Ahmedredamohamed2022/EF_R2RVC02/doc/_static/layout.png

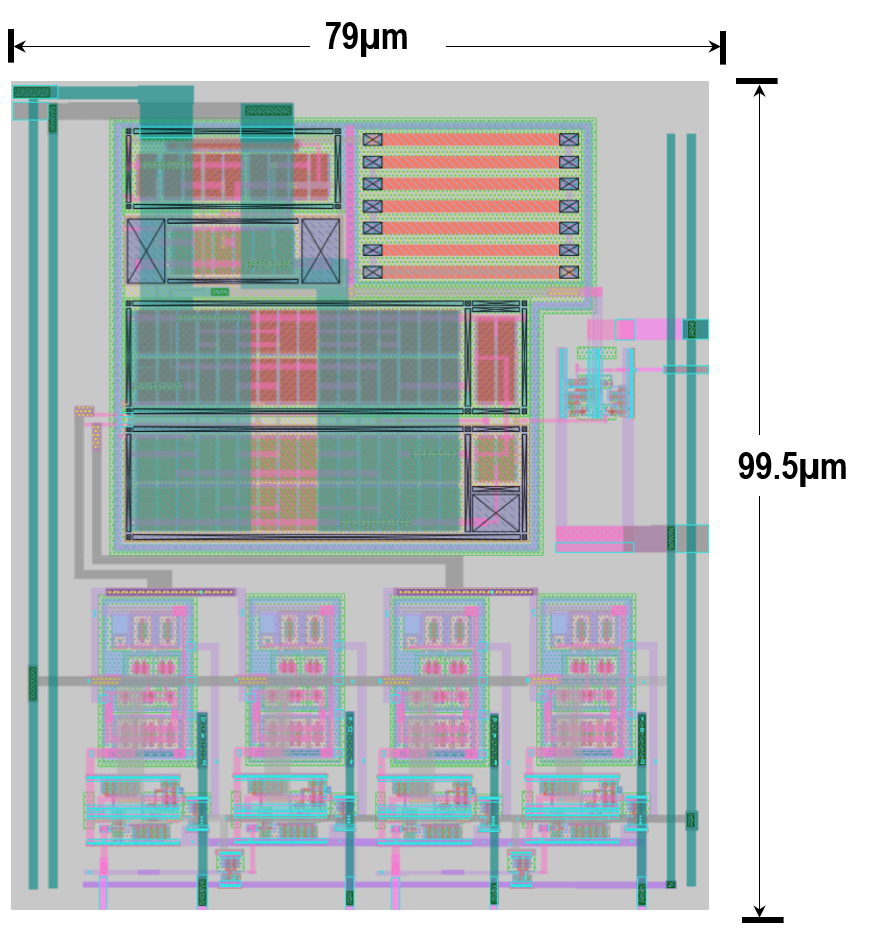
doc/_static/layout.png
